MilkyCookie1to2/Diploma/README.md

# Diploma

## Тема: "Аппаратно-программная система управления для симулятора компьютерной игры "Пинг-Понг""

Дипломный проект состоит из двух частей: аппаратной и программной. Аппаратная часть включает в себя пульт управления моделями игроков с подключением к игровой платформе по радиоканалу. Программная часть представляет собой приложение, которое может подключаться к игровой платформе и тоже выполнять управление перемещением игрока и возможностью отталкивания мяча. Кроме того, приложение отображает видео, полученное от ESP32-CAM модуля, а так же имеет функцию распознавания мяча в потоке видеоданных.
