MilkyCookie1to2/Diploma/Пояснялка/Ведомость.pdf

Изм. Лист | | № докум. | Подп. | Дата
Разраб. | Гриненко | | | Аппаратно-программная система управления для симулятора компьютерной игры «Пинг-Понг». Ведомость документов | Лит. | Лист | Листов
Пров. | Некревич | | | | | У | | 1 | 2
Т. контр. | Некревич | | | | ЭВМ, гр. 050502
Н. контр. | Стракович
Утв. | Никульшин

## БГУИР ДП 1–400201 01 025 Д1

Обозначение | Наименование | Примечание
| Графические документы
ГУИР.400201.025 МЭ | Аппаратная часть.
| Чертеж электромонтажный | А2
ГУИР.400201.025 ПД | Аппаратная часть.
| Схема программы | А1
ГУИР.400201.025 ПЛ.1 | Вводный плакат. Плакат | А1
ГУИР.400201.025 ПЛ.2 | Заключительный плакат. Плакат | А1
ГУИР.400201.025 РР.1 | Программная часть.
| Диаграмма последовательности | А2
ГУИР.400201.025 РР.2 | Программная часть.
| Диаграмма классов | А3, в ПЗ
ГУИР.400201.025 С1 | Программная часть.
| Схема структурная | А2
ГУИР.400201.025 Э1 | Аппаратная часть.
| Схема электрическая структурная | А2
ГУИР.400201.025 Э2 | Аппаратная часть.
| Схема электрическая функциональная | А2
ГУИР.400201.025 Э3 | Аппаратная часть.
| Схема электрическая принципиальная | А2
| Текстовые документы
БГУИР ДП БГУИР ДП 1–400201 01 025 400201 01 025 ПЗ | Пояснительная записка Пояснительная записка | 116 с.
ГУИР.400201.025 Д2 ГУИР.400201.025 Д2 | Аппаратно-программная система Аппаратно-программная система
| управления для симулятора управления для симулятора
| компьютерной игры «Пинг-Понг». компьютерной игры «Пинг-Понг».
| Спецификация | 3 л., в ПЗ

Изм. Лист | № докум. | Подп. | Дата

## БГУИР ДП 1–400201 01 025 Д1

Лист
2
Обозначение | Наименование | Примечание
ГУИР.400201.025 ПЭ3 ГУИР.400201.025 ПЭ3 | Аппаратно-программная система Аппаратно-программная система
| управления для симулятора управления для симулятора
| компьютерной игры «Пинг-Понг». компьютерной игры «Пинг-Понг».
| Перечень элементов | 1 л., в ПЗ
| Отзыв руководителя
| Отчет проверки на заимствования | 4 л.
| Рецензия
