MilkyCookie1to2/Diploma/Пояснялка/Перечень элементов.pdf

Изм. Лист | | № докум. | Подп. | Дата
Разраб. | Гриненко | | | Аппаратная часть. Перечень элементов | Лит. | Лист | Листов
Пров. | Некревич | | | | | У | | 1
Т. контр. | Некревич | | | | ЭВМ, гр. 050502
Н. контр. | Стракович
Утв. | Никульшин
Поз. обозна-чение | Наименование | | Примечание
| Конденсаторы
C1 C1 | CL31A107MQHNNNE, конденсатор SMD 1206 CL31A107MQHNNNE, конденсатор SMD 1206
| 100мкФ 6.3В (X5R) ±20% 100мкФ 6.3В (X5R) ±20% | 2 2

Зона
Кол.
| Микросхемы
BA1 | HC0905T/208, 5В, 9мм, пьезоизлучатель | 2
DD1 | HW-373 v1.1 373 v1.1, плата защиты аккумулятора плата защиты аккумулятора | 2
DD2 DD3 | KY-023, двухосевой джойстик , двухосевой джойстик GME12864 GME12864-49, дисплей , дисплей | 2 2
DD4 | NRF24L01, модуль радиопередачи | 2
DD5 | 662K, стабилизатор напряжения , стабилизатор напряжения | 2
DD6 DD6 | MINGWU DCDC5.0V, повышающий MINGWU DCDC5.0V, повышающий
| DC-DC преобразователь DC-DC преобразователь | 2 2
DD7 | Arduino Nano v3.0, отладочная плата | 2
| Резисторы
R1...R3 R1...R3 | 0805S8J0103T5E резистор SMD 0805, 10кОм 0805S8J0103T5E резистор SMD 0805, 10кОм
| 0.125 Вт, ±5% 0.125 Вт, ±5% | 6 6
| Устройства коммутации
BTN1... BTN1...
BTN2 | KLS7-TS6606-5.0, тактовая кнопка KLS7-TS6606-5.0, тактовая кнопка | 4 4
BTN3 | KAN0611 KAN0611-0901B, тактовая кнопка тактовая кнопка | 2
SW1 SW1 | L-KLS7-SK02-12E12-EG7, переключатель L-KLS7-SK02-12E12-EG7, переключатель
| движковый, ВКЛ-ВКЛ движковый, ВКЛ-ВКЛ | 2 2
| Разъёмы
XP1 XP1 | PLS-2 (DS-1021-1x1), вилка штыревая PLS-2 (DS-1021-1x1), вилка штыревая
| шаг 2.54мм, 2 контакта, прямая шаг 2.54мм, 2 контакта, прямая | 2 2
| | | ГУИР.400201.025 ПЭ3
