MilkyCookie1to2/Diploma/Пояснялка/Спецификация.pdf

Изм. Лист | | № докум. | Подп. | Дата
Разраб. | Гриненко | | | Аппаратно-программная система управления для симулятора компьютерной игры «Пинг-Понг». Спецификация | Лит. | Лист | Листов
Пров. | Некревич | | | | | У | | 3
Т. контр. | Некревич | | | | ЭВМ, гр. 050502
Н. контр. | Стракович
Утв. | Никульшин

## ГУИР.400201.025 Д2

Обозначение | Наименование | Примечание
| Документация
12-01 | Текст программы | В составе пояснительной записки
51-01 | Программа и методика
| испытаний | В составе пояснительной записки
81-01 | Пояснительная записка
90-01 | Руководство пользователя | В составе пояснительной записки

Компоненты
PPM/arrow_icon.svg.
Графический файл | На DVD-R диске «Гриненко»
PPM/heal_icon.svg.
Графический файл | На DVD-R диске «Гриненко»
PPM/heart_icon.svg.
Графический файл | На DVD-R диске «Гриненко»
PPM/connectiontoplayer.h.
Заголовочный файл | На DVD-R диске «Гриненко»
PPM/detectball.h.
Заголовочный файл | На DVD-R диске «Гриненко»
PPM/gameinfo.h.
Заголовочный файл | На DVD-R диске «Гриненко»
PPM/manageplayer.h.
Заголовочный файл | На DVD-R диске «Гриненко»
PPM/receiverdata.h.
Заголовочный файл | На DVD-R диске «Гриненко»
PPM/sendersignals.h.
Заголовочный файл | На DVD-R диске «Гриненко»
PPM/socket.h.
Заголовочный файл | На DVD-R диске «Гриненко»

Обозначение | Наименование | Примечание
| PPM/videocamcapture.h.
| Заголовочный файл | На DVD-R диске «Гриненко»
| PingPongMobile.apk.
| Исполняемый файл | На DVD-R диске «Гриненко»
| Demo_video.mp4.
| Мультимедийный файл | На DVD-R диске «Гриненко»
| Презентация.pptx.
| Мультимедийный файл | На DVD-R диске «Гриненко»
| readme.txt.
| Текстовый файл | На DVD-R диске «Гриненко»
| 3ds/Top.stl.
| Файл с 3Д-моделью | На DVD-R диске «Гриненко»
| 3ds/Bottom.stl.
| Файл с 3Д-моделью | На DVD-R диске «Гриненко»
| 3ds/Top_button.stl.
| Файл с 3Д-моделью | На DVD-R диске «Гриненко»
| 3ds/Side_button.stl.
| Файл с 3Д-моделью | На DVD-R диске «Гриненко»
| PPC/CodeController.ino.
| Файл с исходными текстами | На DVD-R диске «Гриненко»
| PPM/AndroidManifest.xml.
| Файл с исходными текстами | На DVD-R диске «Гриненко»
| PPM/connectiontoplayer.cpp.
| Файл с исходными текстами | На DVD-R диске «Гриненко»
| PPM/detectball.cpp.
| Файл с исходными текстами | На DVD-R диске «Гриненко»
| PPM/gameinfo.cpp.
| Файл с исходными текстами | На DVD-R диске «Гриненко»
| PPM/main.cpp.
| Файл с исходными текстами | На DVD-R диске «Гриненко»
| PPM/main.qml.
| Файл с исходными текстами | На DVD-R диске «Гриненко»
| | | ГУИР.400201.025 Д2 | Лист
Изм. Лист | № докум. | Подп. | Дата

Обозначение | Наименование | Примечание
| PPM/manageplayer.cpp.
| Файл с исходными текстами | На DVD-R диске «Гриненко»
| PPM/PingPong_Mobile.pro.
| Файл с исходными текстами | На DVD-R диске «Гриненко»
| PPM/receiverdata.cpp.
| Файл с исходными текстами | На DVD-R диске «Гриненко»
| PPM/sendersignals.cpp.
| Файл с исходными текстами | На DVD-R диске «Гриненко»
| PPM/SharinganLoader.qml.
| Файл с исходными текстами | На DVD-R диске «Гриненко»
| PPM/socket.cpp.
| Файл с исходными текстами | На DVD-R диске «Гриненко»
| PPM/videocamcapture.cpp.
| Файл с исходными текстами | На DVD-R диске «Гриненко»
| PPM/WiFiApi.java.
| Файл с исходными текстами | На DVD-R диске «Гриненко»
Изм. Лист | № докум. | Подп. | Дата

## ГУИР.400201.025 Д2

Лист
