MilkyCookie1to2/Diploma/Пояснялка/Графический материал/Принципиальная схема.pdf

D

A

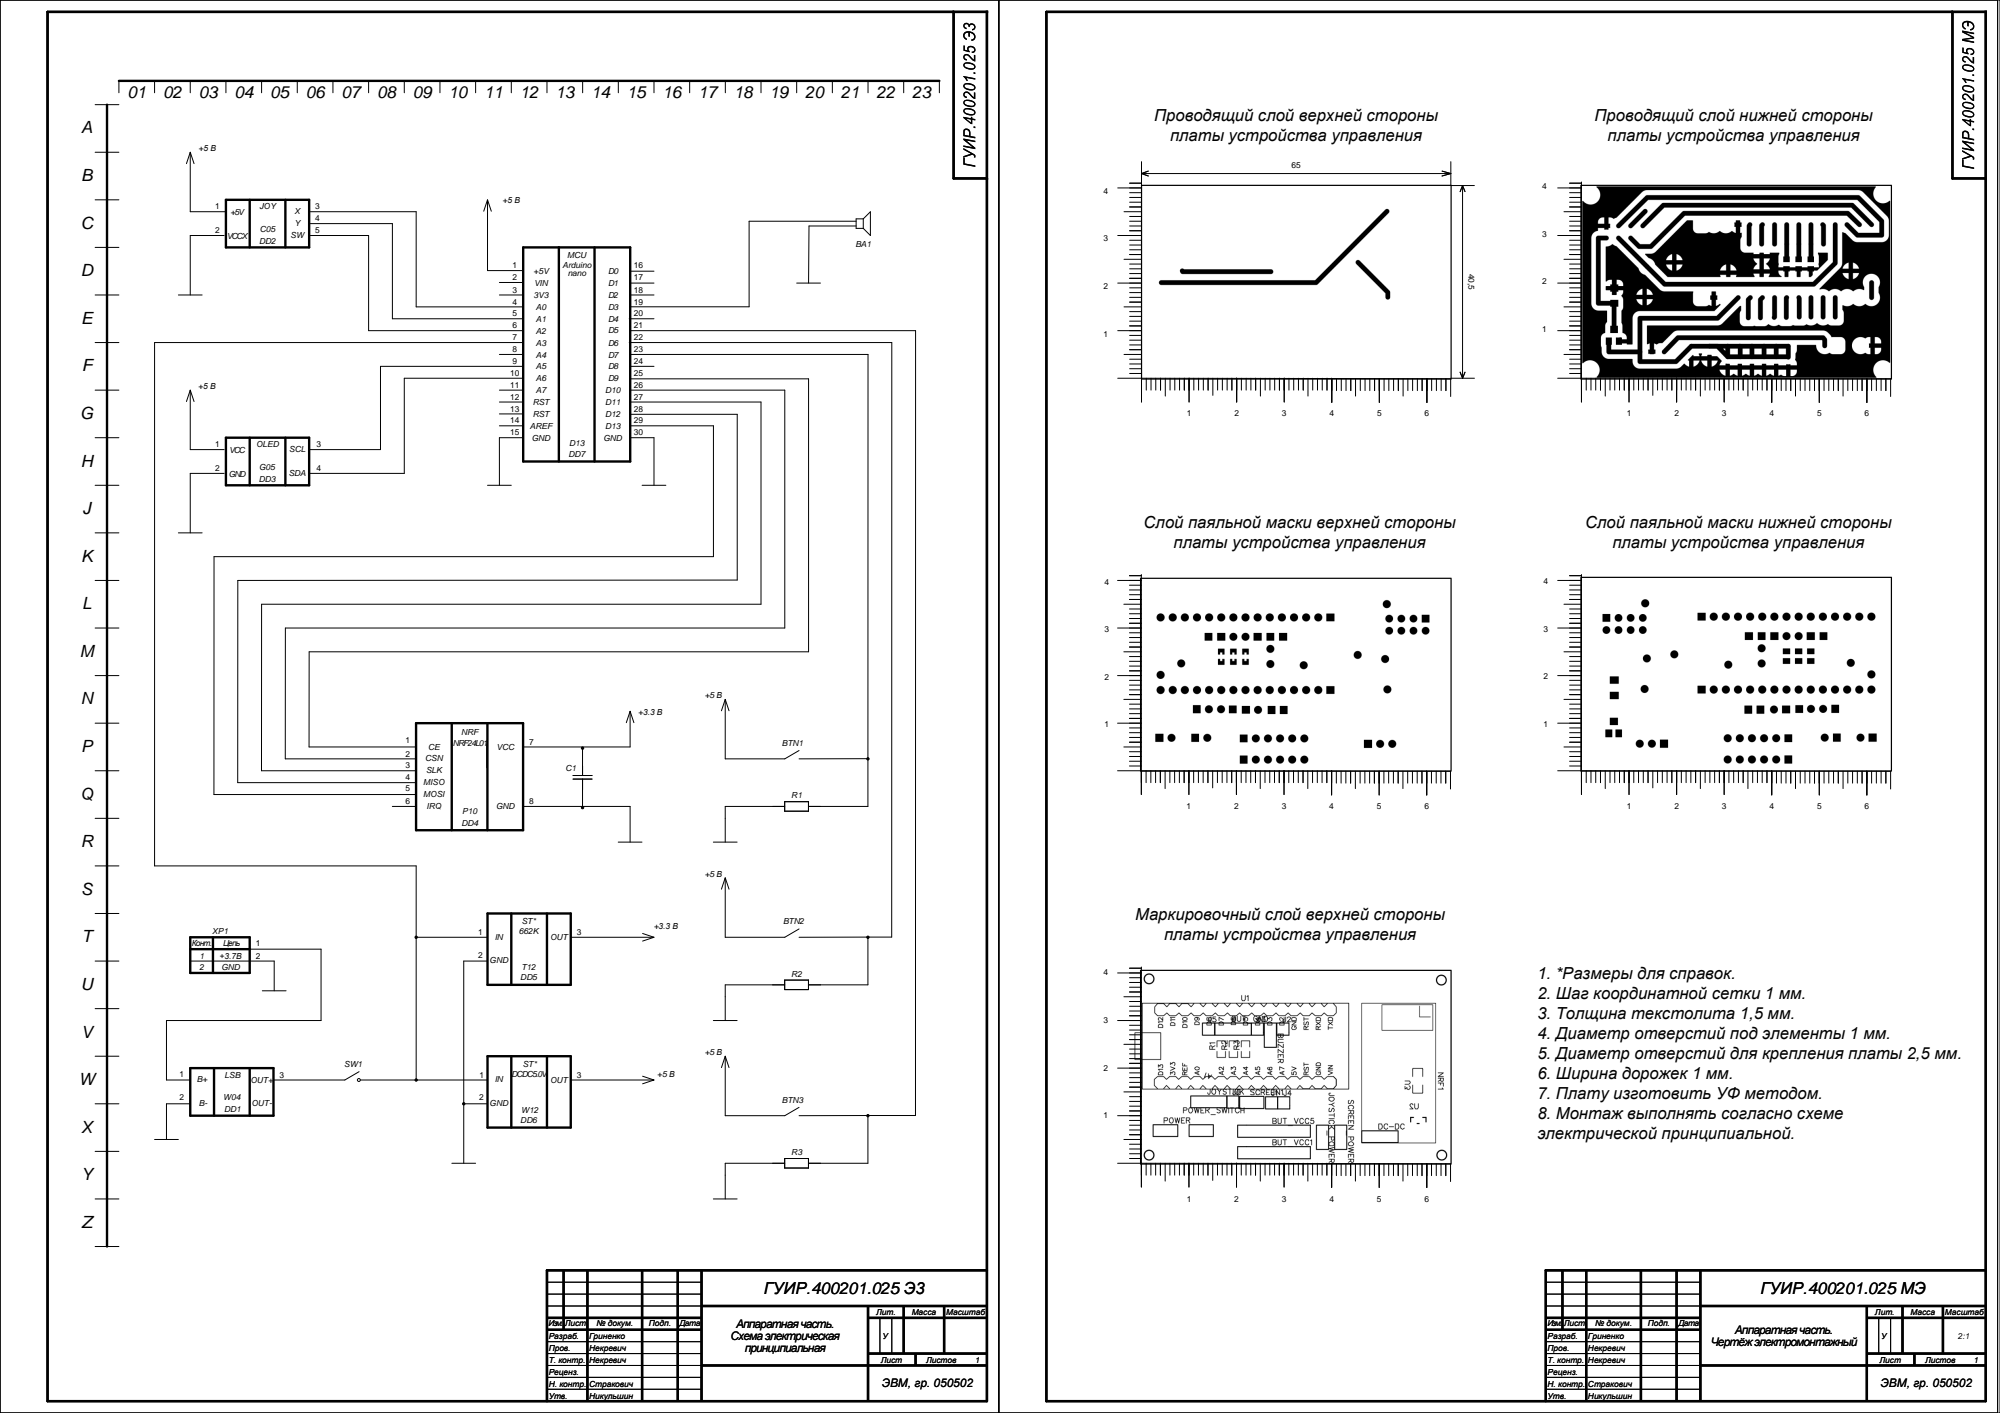
[picture p38: page 1]

Проводящий слой верхней стороны
платы устройства управления

Проводящий слой нижней стороны

VCCX | JOY +5V C05 DD2 | X Y SW

+5V VIN 3V3 A0 A1 A2 A3 A4 A5 A6 A7 RST RST AREF GND | MCU Arduino nano D13 DD7 | D0 D1 D2 D3 D4 D5 D6 D7 D8 D9 D10 D11 D12 D13 GND

Слой паяльной маски верхней стороны

Слой паяльной маски нижней стороны

Маркировочный слой верхней стороны

1 | +3.7В | 2
2 | GND

1. *Размеры для справок.
2. Шаг координатной сетки 1 мм.
3. Толщина текстолита 1,5 мм.
4. Диаметр отверстий под элементы 1 мм.
5. Диаметр отверстий для крепления платы 2,5 мм.
6. Ширина дорожек 1 мм.
7. Плату изготовить УФ методом.
8. Монтаж выполнять согласно схеме
электрической принципиальной.
