MilkyCookie1to2/Diploma/Пояснялка/Графический материал/Функциональная схема.pdf

BTN | LCD

# NRF

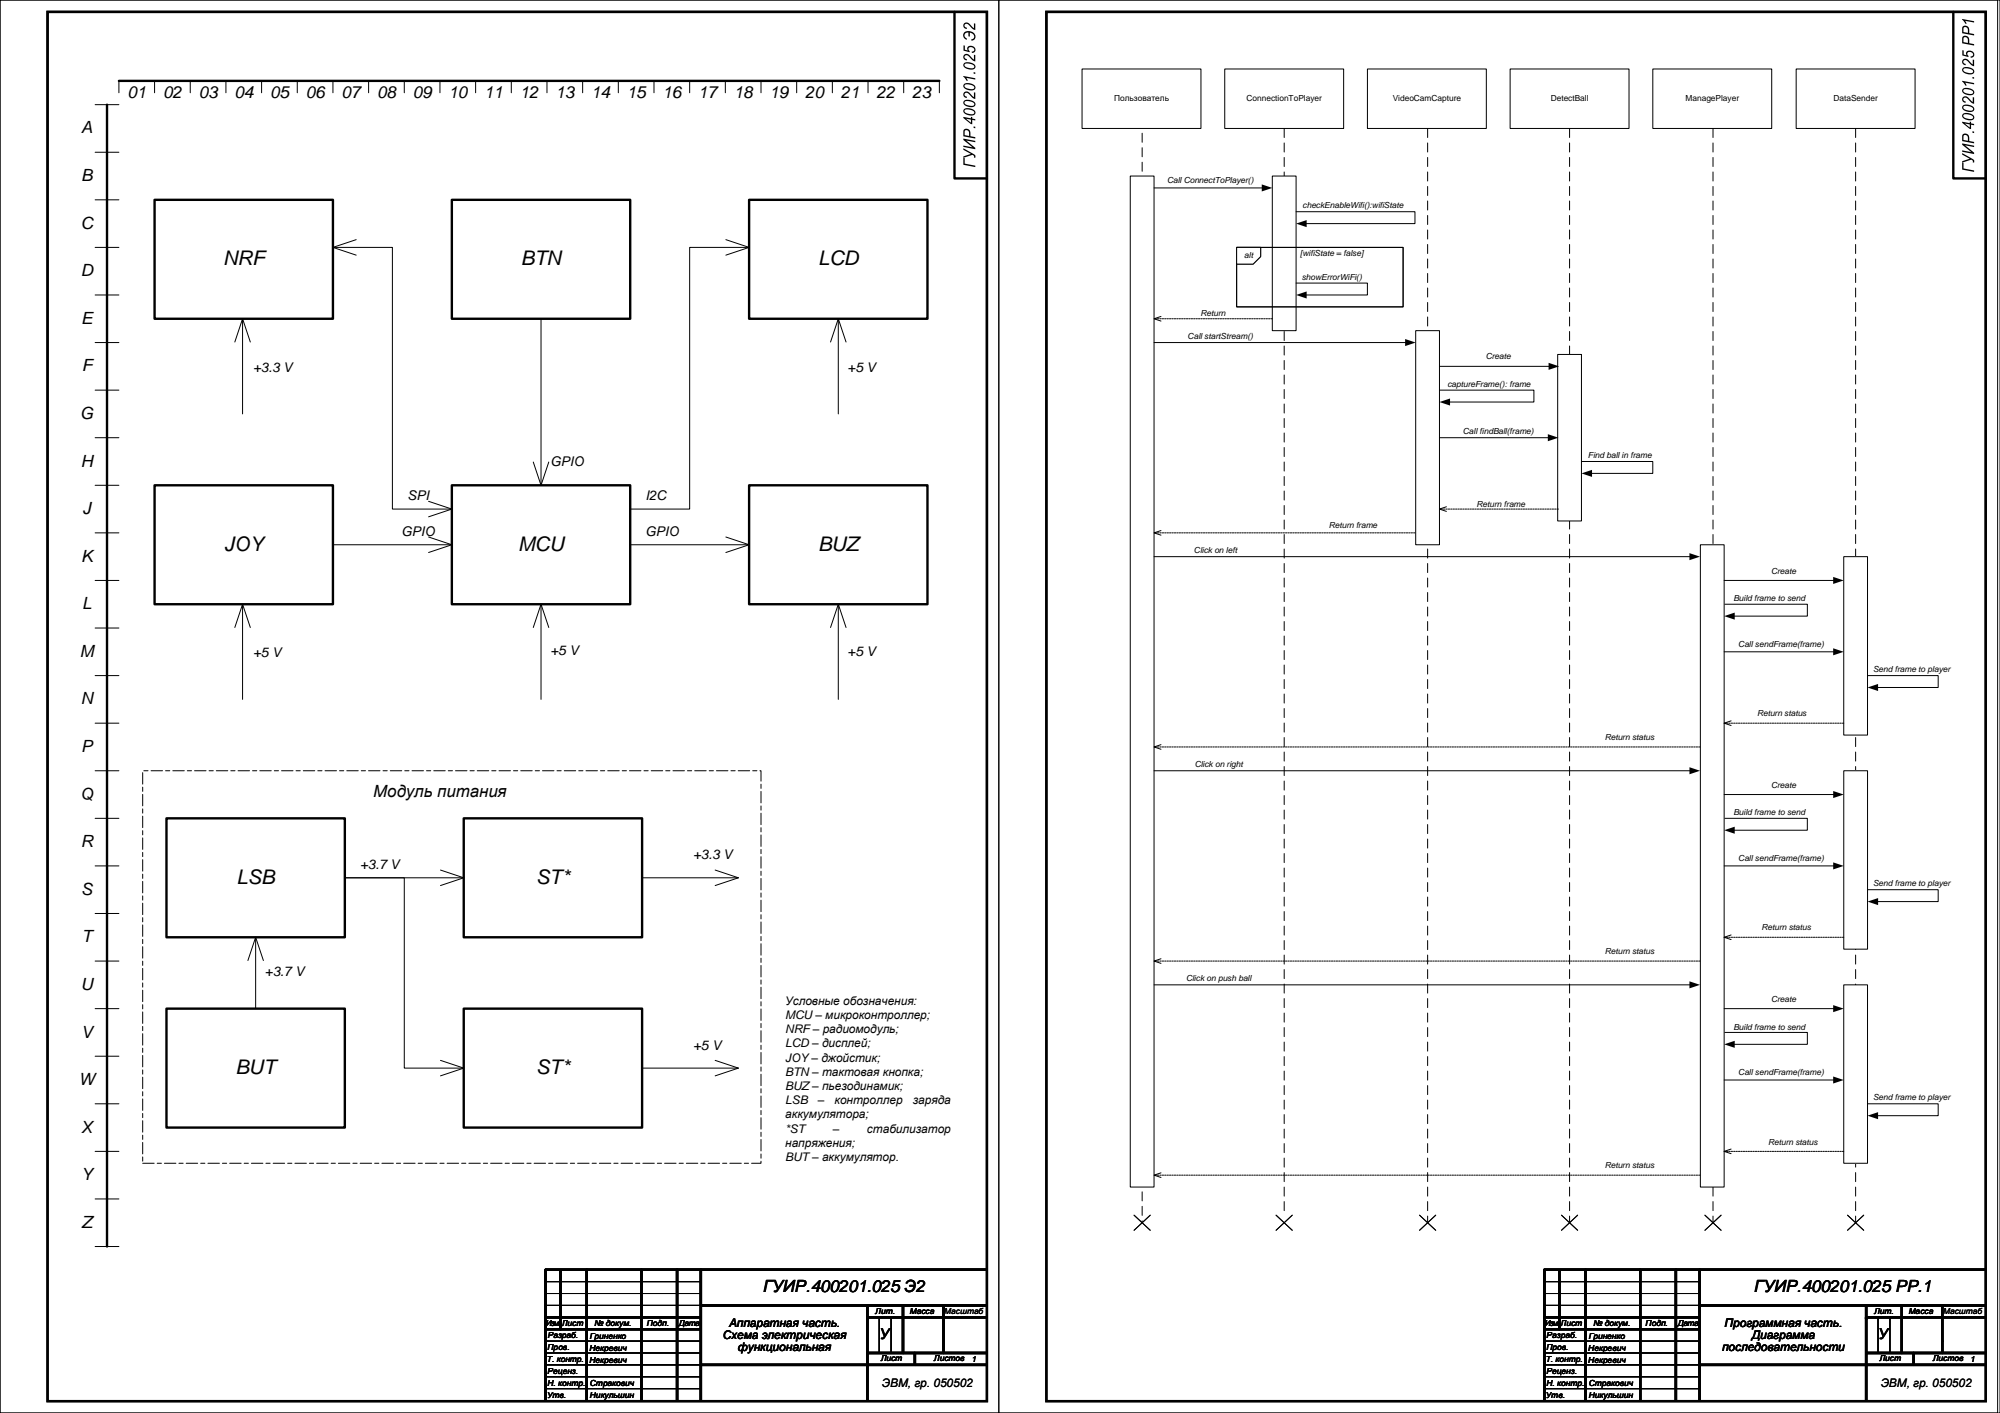
[picture p39: page 1]
ЭВМ, гр. 050502; Масштаб; ГУИР.400201.025 Э2; Аппаратная часть. Схема электрическая функциональная; Стракович; Никульшин; Изм.Лист; № докум.; Подп.; Дата; Разраб.; Пров.; Т. контр.; Н. контр.; Утв.; Гриненко; Лит.; Масса; Лист; Листов; Реценз.; Некревич Некревич; ГУИР.400201.025 PP.1; Программная часть. Диаграмма последовательности; MCU; LSB; JOY; BUT; BUZ; GPIO; SPI; Модуль питания; стабилизатор; ConnectionToPlayer; ManagePlayer; checkEnableWifi():wifiState; alt; [wifiState = false]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

Call findBall(frame)

Find ball in frame

Click on left

Build frame to send

Call sendFrame(frame)

Send frame to player

Click on right

Click on push ball

Условные обозначения:
MCU – микроконтроллер;
NRF – радиомодуль;
LCD – дисплей;
JOY – джойстик;
BTN – тактовая кнопка;
BUZ – пьезодинамик;
LSB – контроллер заряда
аккумулятора;
напряжения;
BUT – аккумулятор.
