MilkyCookie1to2/Diploma/Пояснялка/Графический материал/Диаграмма классов.pdf

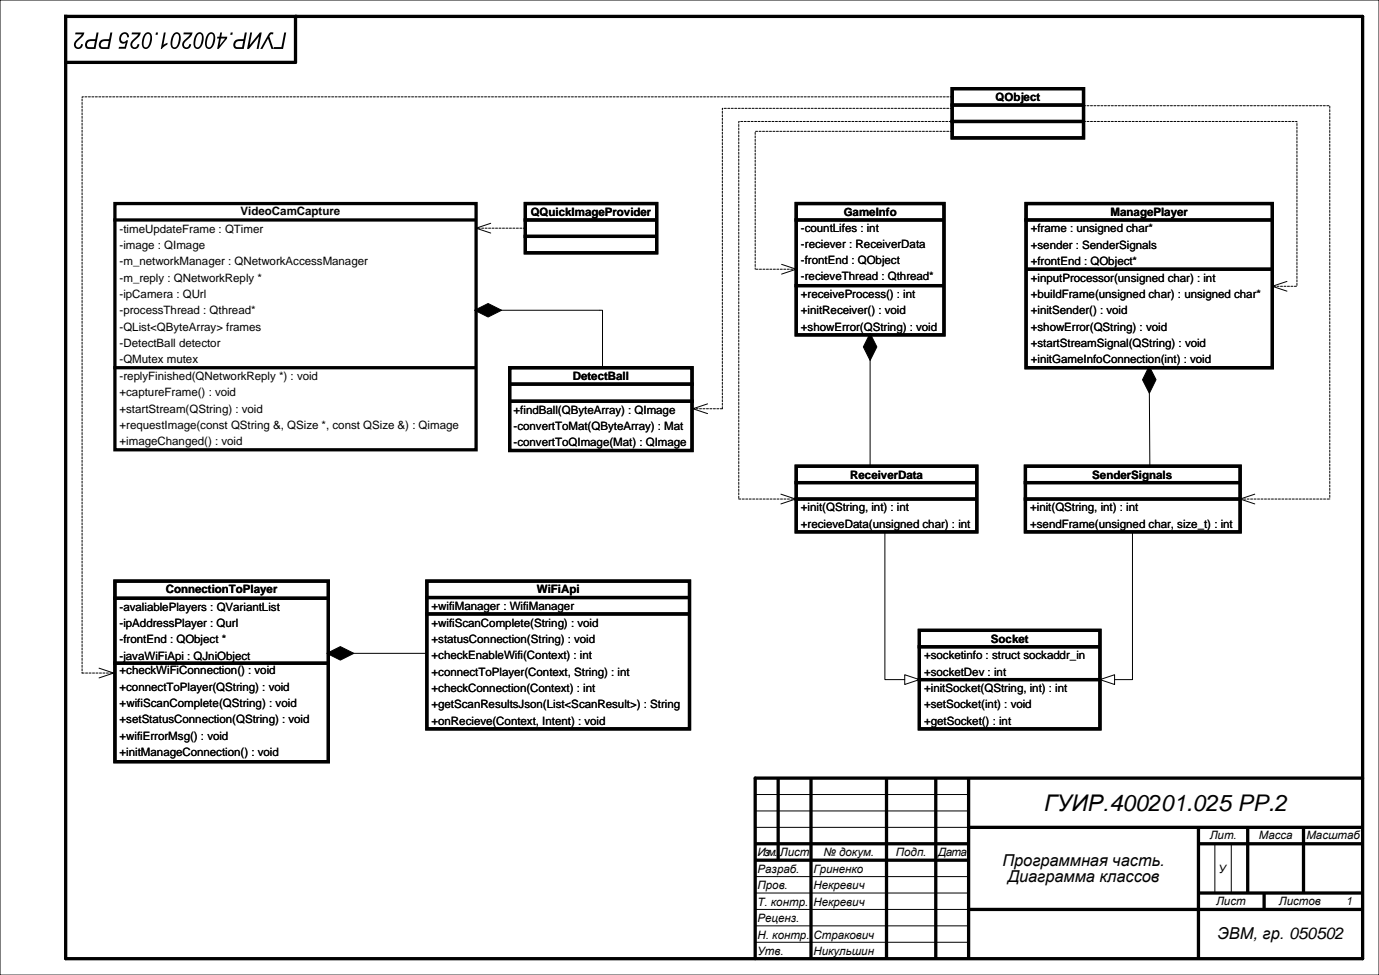
[picture p42: page 1]
QObject; DetectBall; GameInfo; ManagePlayer; SenderSignals; ReceiverData; Socket; VideoCamCapture; QQuickImageProvider; WiFiApi; ConnectionToPlayer

-timeUpdateFrame : QTimer
-image : QImage
-m_networkManager : QNetworkAccessManager
-m_reply : QNetworkReply *
-ipCamera : QUrl
-processThread : Qthread*
-QList<QByteArray> frames
-DetectBall detector
-QMutex mutex
-replyFinished(QNetworkReply *) : void
+captureFrame() : void
+startStream(QString) : void
+requestImage(const QString &, QSize *, const QSize &) : Qimage
+imageChanged() : void

-countLifes : int
-reciever : ReceiverData
-frontEnd : QObject
-recieveThread : Qthread*
+receiveProcess() : int
+initReceiver() : void
+showError(QString) : void

+frame : unsigned char*
+sender : SenderSignals
+frontEnd : QObject*
+inputProcessor(unsigned char) : int
+buildFrame(unsigned char) : unsigned char*
+initSender() : void
+startStreamSignal(QString) : void
+initGameInfoConnection(int) : void

+findBall(QByteArray) : QImage
-convertToMat(QByteArray) : Mat
-convertToQImage(Mat) : QImage

+init(QString, int) : int
+recieveData(unsigned char) : int

+sendFrame(unsigned char, size_t) : int

-avaliablePlayers : QVariantList
-ipAddressPlayer : Qurl
-frontEnd : QObject *
-javaWiFiApi : QJniObject
+checkWiFiConnection() : void
+connectToPlayer(QString) : void
+wifiScanComplete(QString) : void
+setStatusConnection(QString) : void
+wifiErrorMsg() : void
+initManageConnection() : void

+wifiManager : WifiManager
+wifiScanComplete(String) : void
+statusConnection(String) : void
+checkEnableWifi(Context) : int
+connectToPlayer(Context, String) : int
+checkConnection(Context) : int
+getScanResultsJson(List<ScanResult>) : String
+onRecieve(Context, Intent) : void

+socketinfo : struct sockaddr_in
+socketDev : int
+initSocket(QString, int) : int
+setSocket(int) : void
+getSocket() : int

ГУИР.400201.025 PP.2

Программная часть. Диаграмма классов | Лит. | Масса | Масштаб

Изм. Лист | | № докум. | Подп. | Дата | | | У
Разраб. | | Гриненко
Пров. | | Некревич
Т. контр. | Некревич | | | | Лист | Листов 1
Реценз. | | | | | ЭВМ, гр. 050502
Н. контр. | Стракович
Утв. | Никульшин
