MilkyCookie1to2/Diploma/Пояснялка/Графический материал/Заключительный плакат.pdf

## Аппаратно-программная система управления для симулятора компьютерной игры «Пинг-Понг»

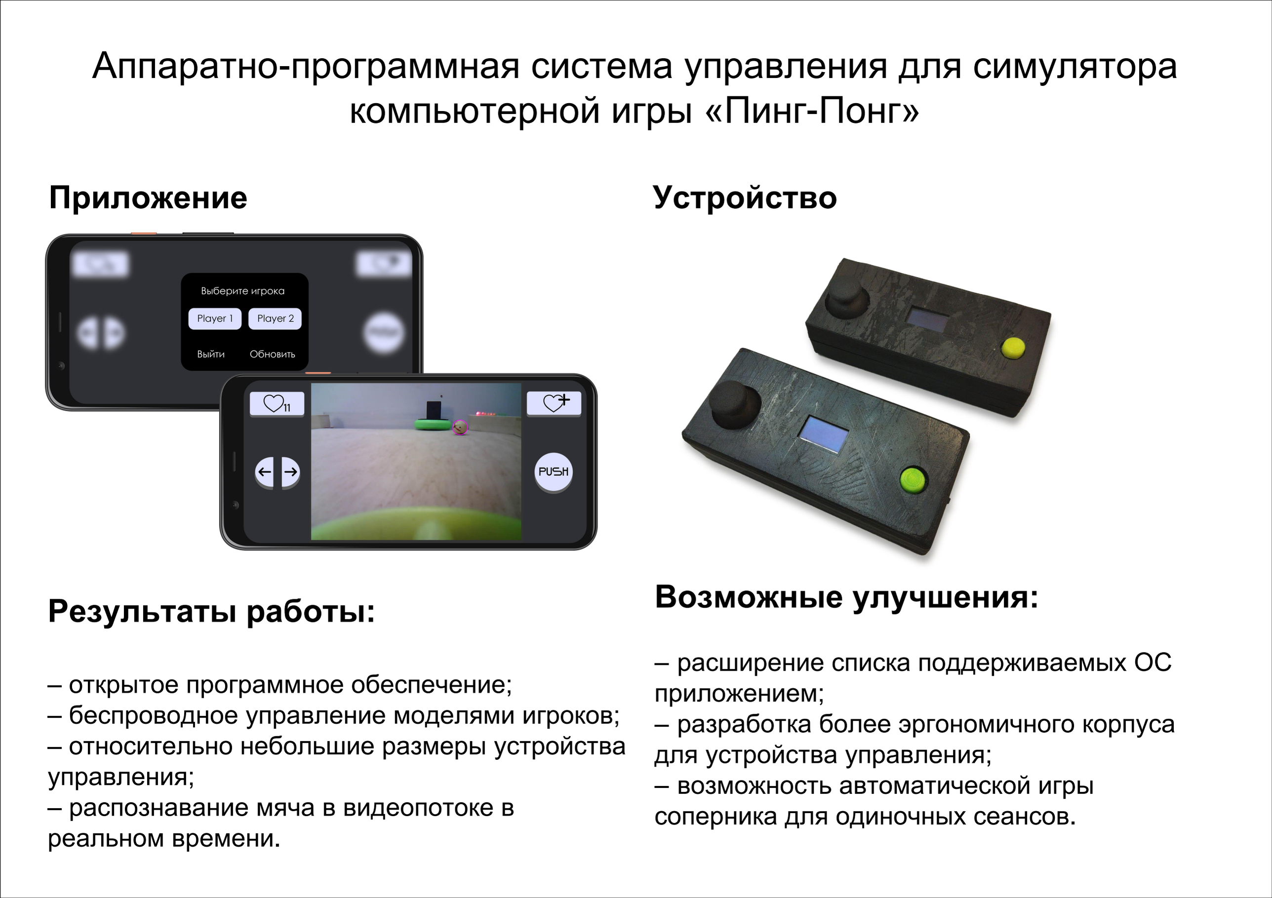
[picture p43: page 1]

### Приложение

### Возможные улучшения:

– расширение списка поддерживаемых ОС приложением;
– разработка более эргономичного корпуса для устройства управления;
– возможность автоматической игры соперника для одиночных сеансов.

### Результаты работы:

– открытое программное обеспечение;
– беспроводное управление моделями игроков; – относительно небольшие размеры устройства управления;
– распознавание мяча в видеопотоке в реальном времени.

### Устройство

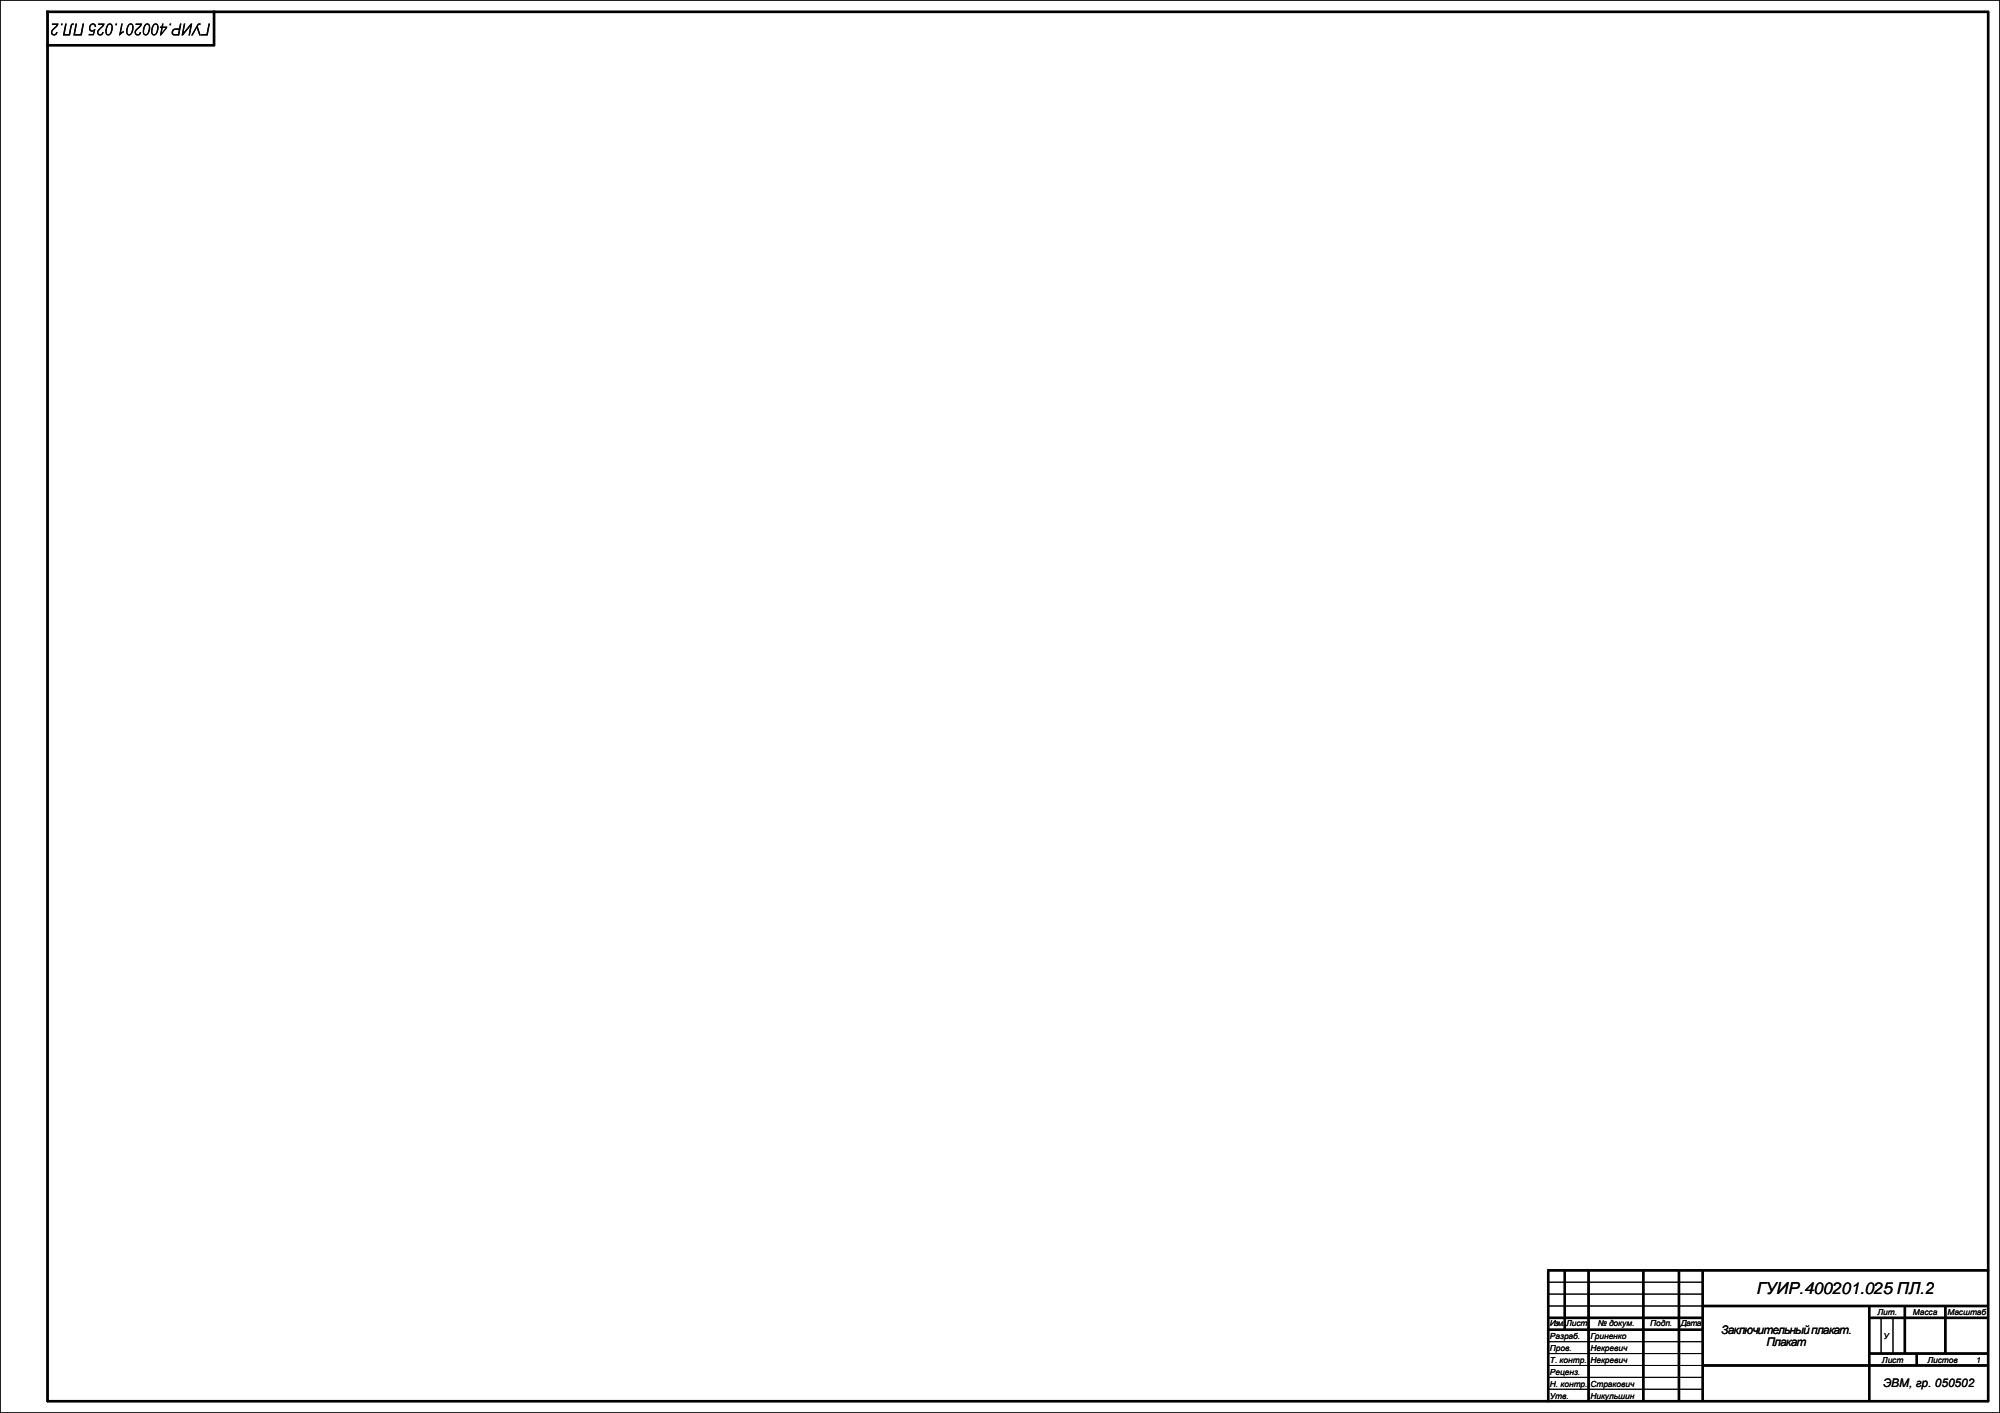
[picture p44: page 2]

ГУИР.400201.025 ПЛ.2

Заключительный плакат. Заключительный плакат. Плакат Плакат | Лит. | Масса | Масштаб

Изм. Лист | | № докум. | Подп. | Дата | | | У У
Разраб. | | Гриненко
Пров. | | Некревич
Т. контр. | Некревич | | | | Лист | Листов Листов 1 1
Реценз. | | | | | ЭВМ, гр. 050502
Н. контр. | Стракович
Утв. | Никульшин
