MilkyCookie1to2/Diploma/Пояснялка/Графический материал/Структурная схема.pdf

# Блок захвата видеоданных с

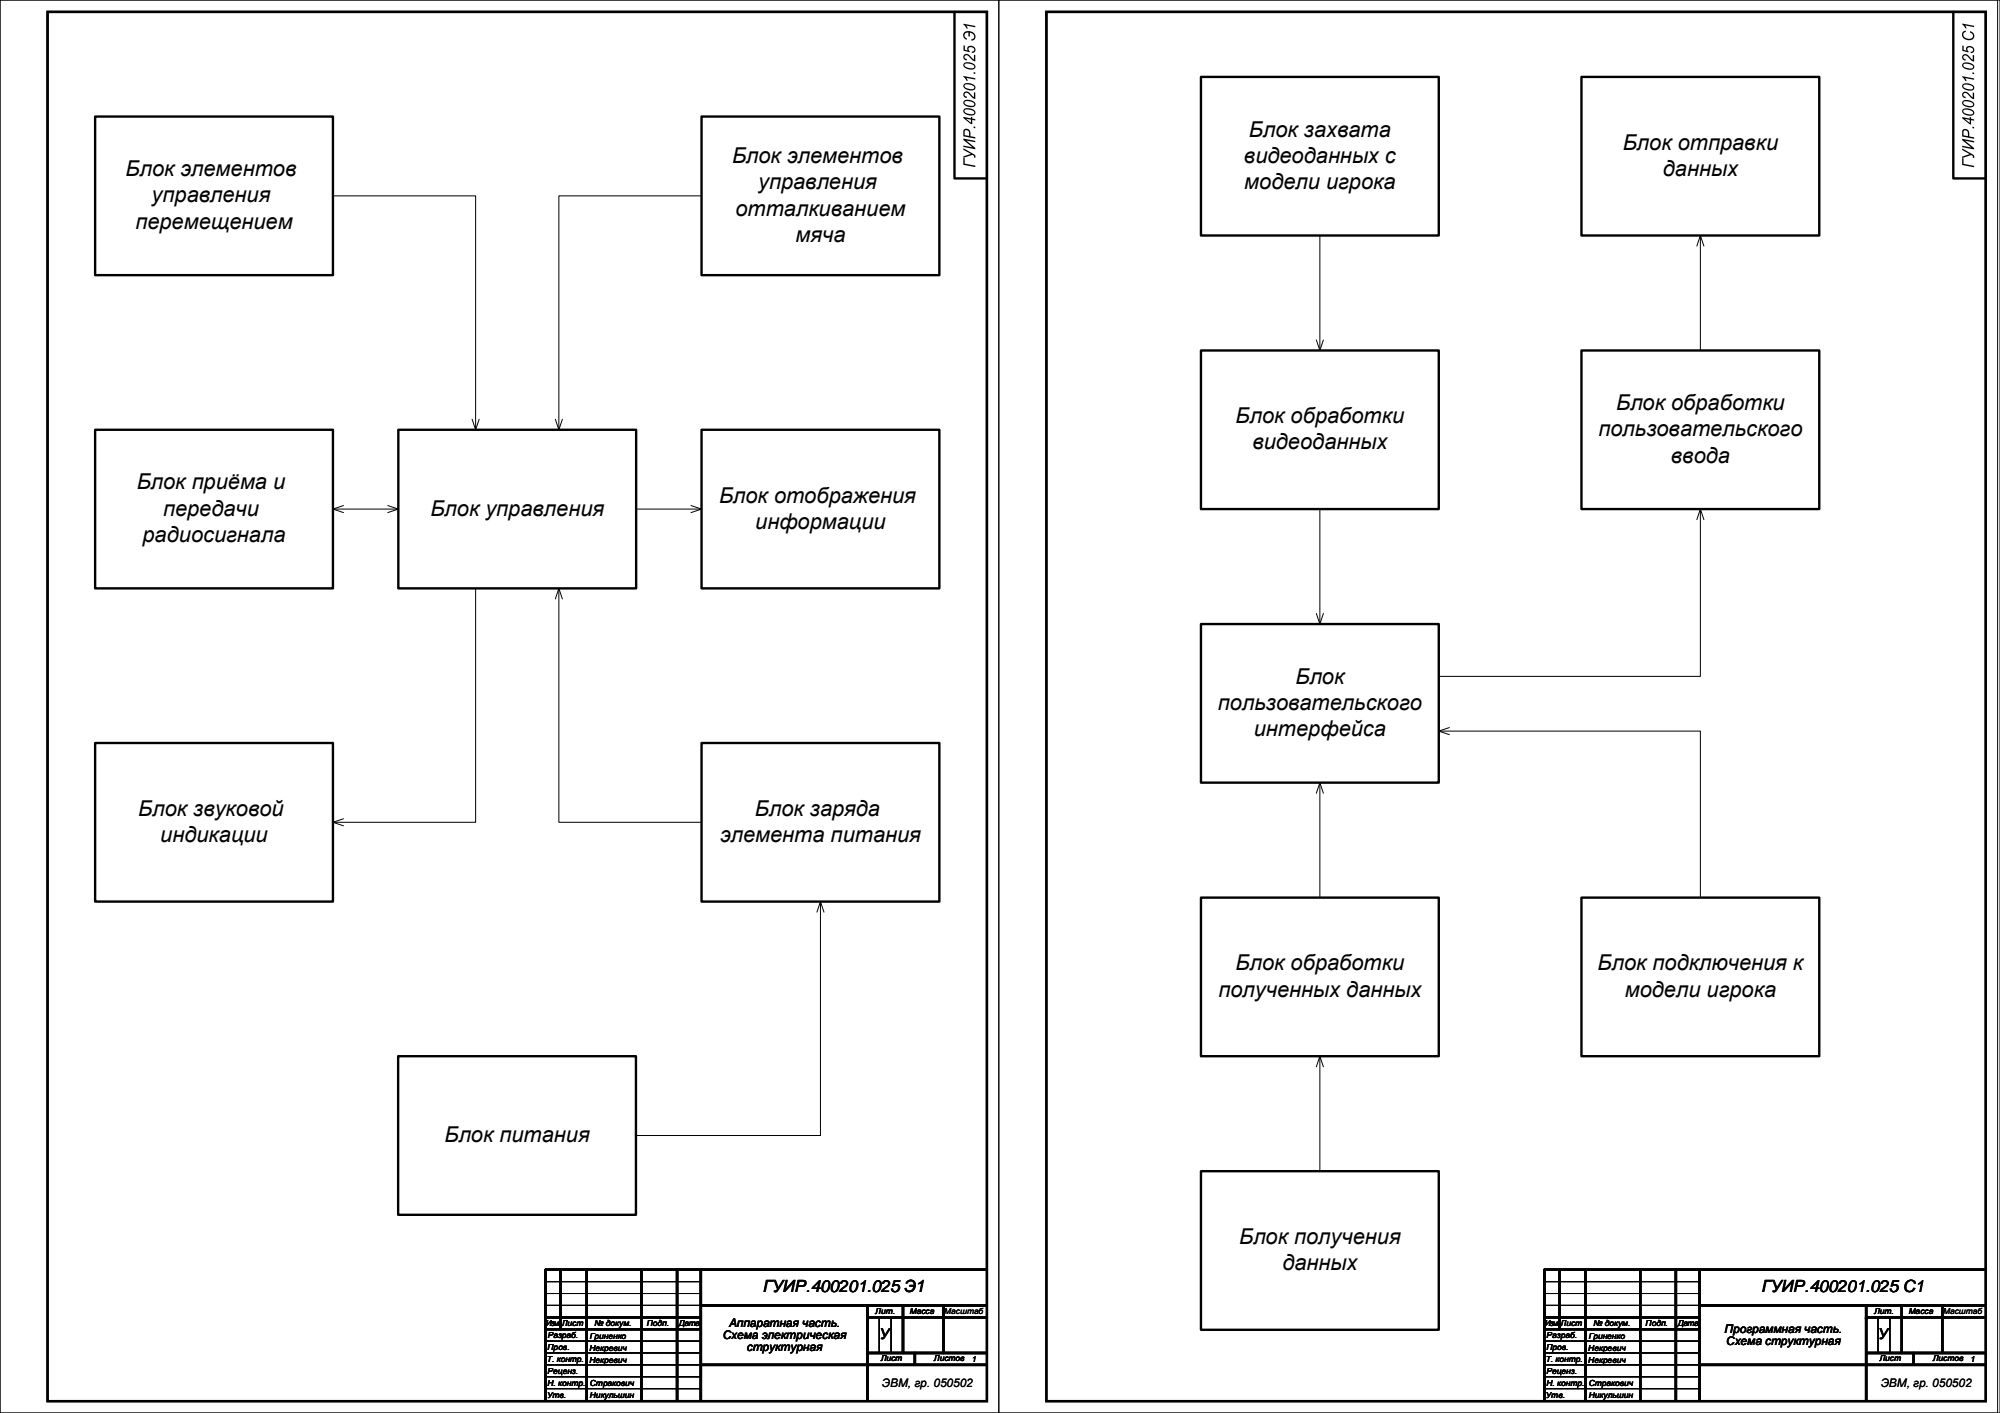
[picture p45: page 1]
ЭВМ, гр. 050502; Масштаб; ГУИР.400201.025 Э1; Аппаратная часть. Схема электрическая структурная; Стракович; Никульшин; Изм.Лист; № докум.; Подп.; Дата; Разраб.; Пров.; Т. контр.; Н. контр.; Утв.; Гриненко; Лит.; Масса; Лист; Листов; Реценз.; Некревич Некревич; ГУИР.400201.025 C1; Программная часть. Схема структурная; Блок питания; Блок пользовательского интерфейса; Блок обработки пользовательского ввода; Блок подключения к модели игрока; модели игрока; Блок отображения информации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

данных Блок элементов
управления
отталкиванием
мяча
