MilkyCookie1to2/Diploma/Пояснялка/Графический материал/Схема программы.pdf

A

B

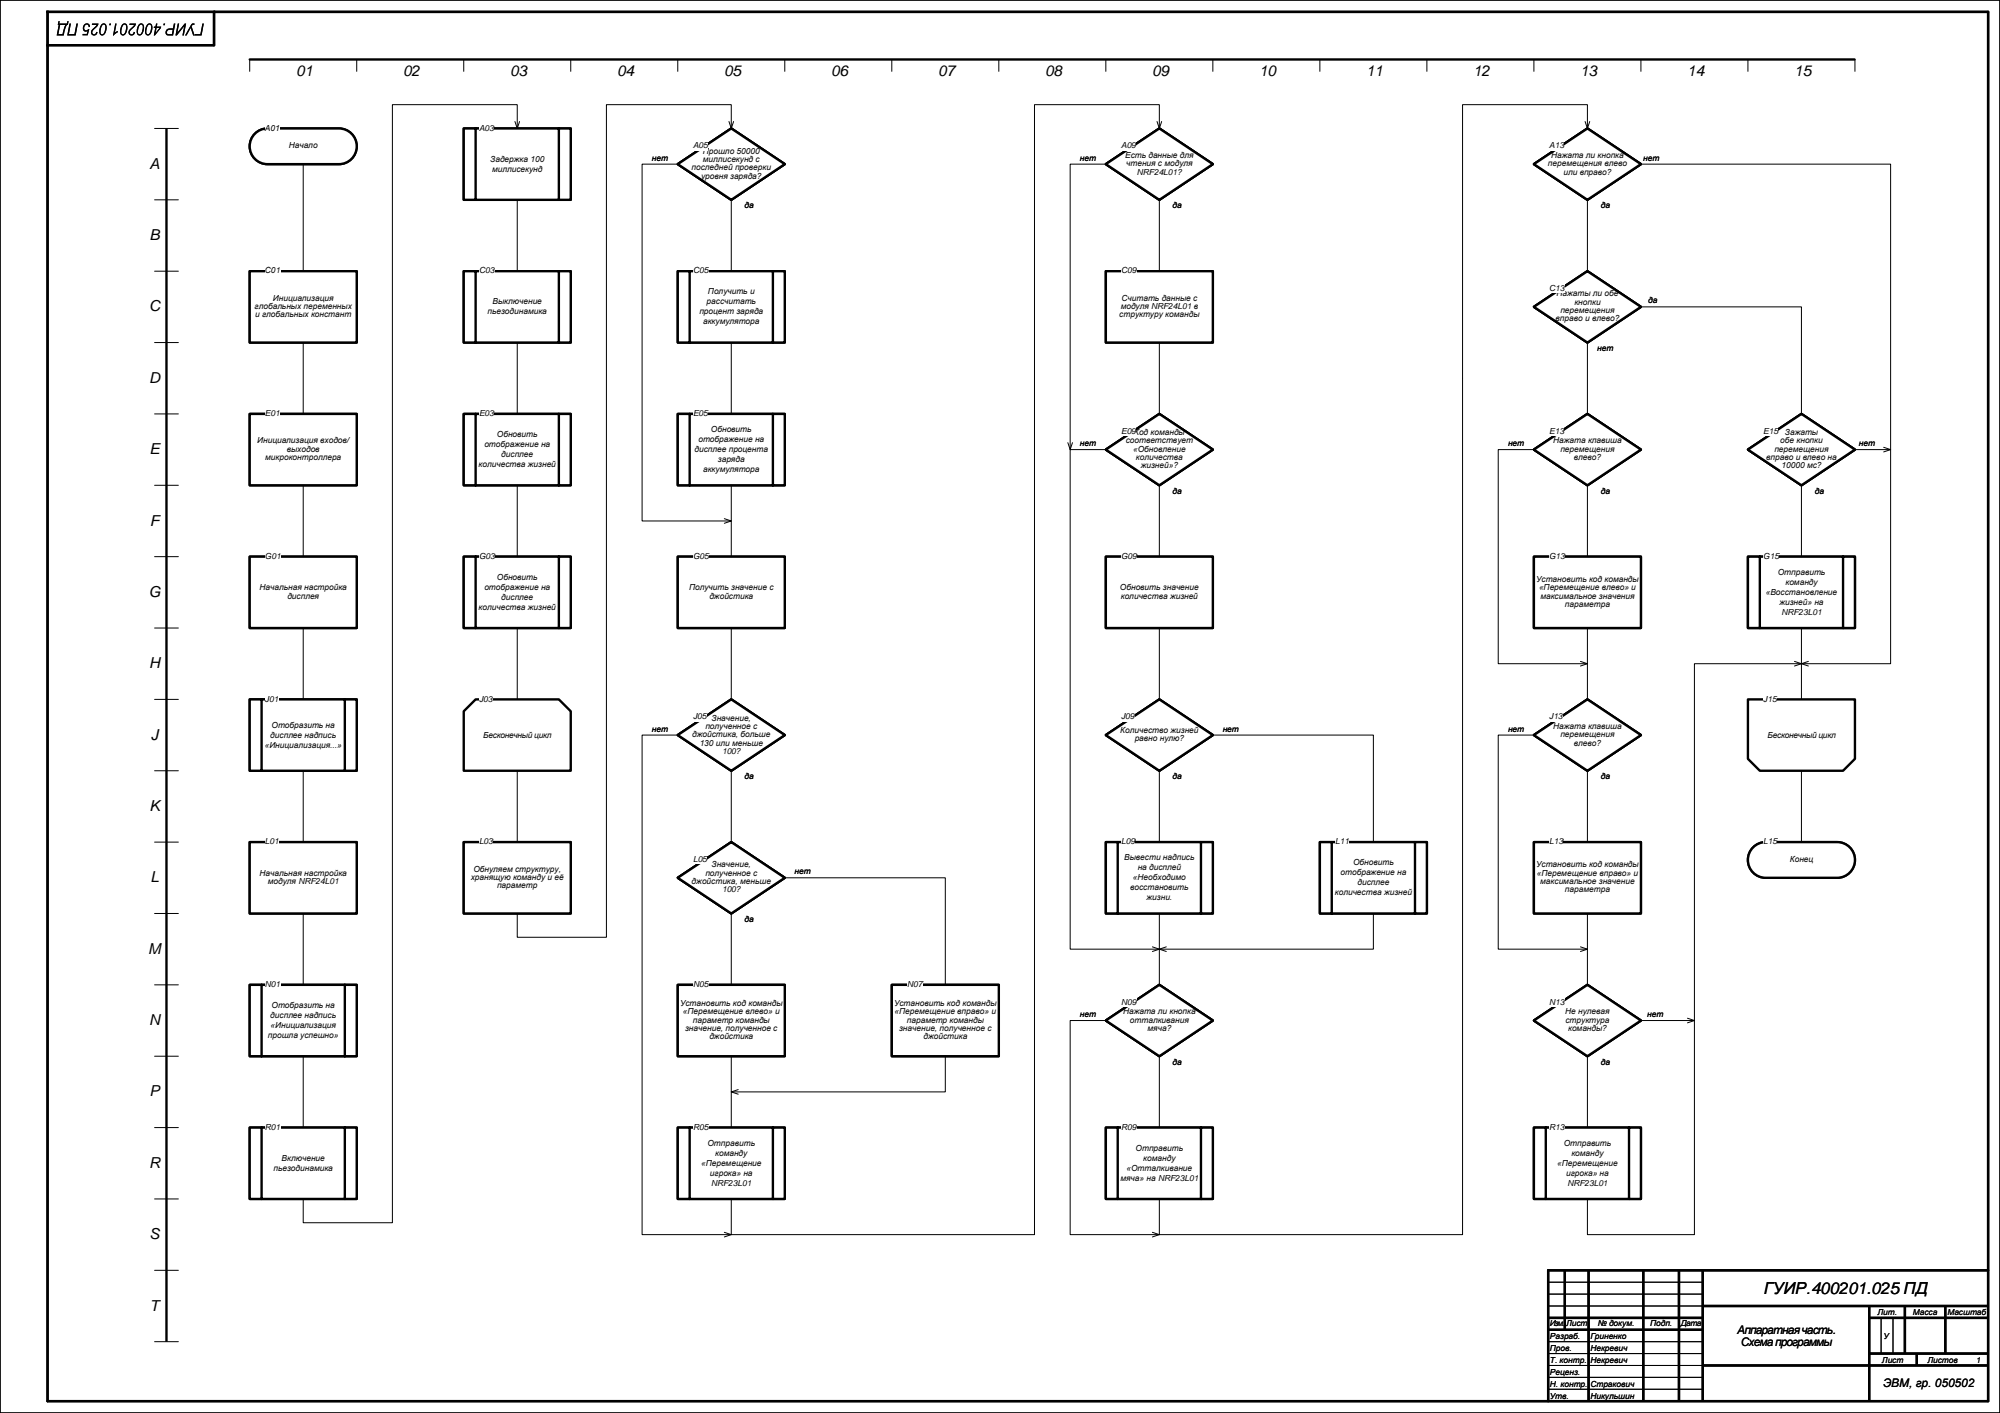
[picture p46: page 1]

ГУИР.400201.025 ПД

Аппаратная часть. Аппаратная часть. Схема программы Схема программы | Лит. | Масса | Масштаб

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
